DimaQSpace/TIA-for-photodiode/Altium Project/TIA_For_Photodiode.step

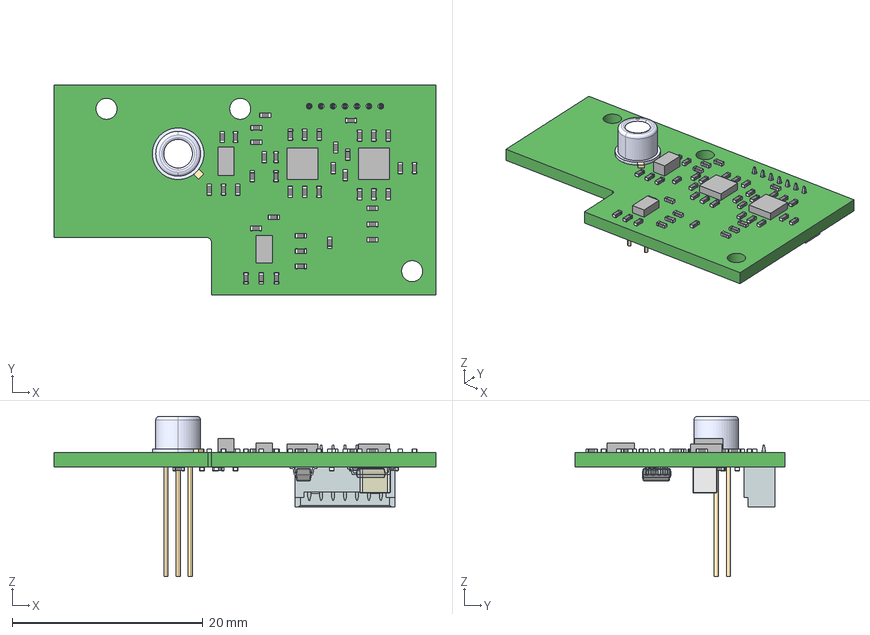
[picture p1: CAD file, 2025-07-08]
Altium Project/TIA_For_Photodiode.step
40.0 x 22.0 x 16.8 mm
res_0402 x 51
IC_BODY
IC_LEG x 5
circle
IC_LEG_MIR7 x 5
Texas Instruments
Analog Devices Logo
Extruded x 4
Cap_Murata_GRM32ER60J107ME20L_eec x 3
Picoblade 7 pins
TO-18
