DimaQSpace/TIA-for-photodiode/(list of files, drawings)

Other design files:
Altium Project/TIA_For_Photodiode.PcbDoc
Altium Project/TIA_For_Photodiode.PrjPcb
Altium Project/TIA_For_Photodiode.SchDoc
