DimaQSpace/TIA-for-photodiode/(commit log)

2025-06-19 First version TIA for photodiode PCB
    [TIA_For_Photodiode.GBL, TIA_For_Photodiode.GBO, TIA_For_Photodiode.GBP, TIA_For_Photodiode.GBS, TIA_For_Photodiode.GTL, TIA_For_Photodiode.GTO, TIA_For_Photodiode.GTP, TIA_For_Photodiode.GTS]
2025-06-28 - AD8065 footprint changed - AD8045 footprint changed - Added several bypass and filter capacitors - Added AD5245 potentiometer
    [TIA_For_Photodiode.GBL, TIA_For_Photodiode.GBO, TIA_For_Photodiode.GBP, TIA_For_Photodiode.GBS, TIA_For_Photodiode.GTL, TIA_For_Photodiode.GTO, TIA_For_Photodiode.GTP, TIA_For_Photodiode.GTS]
2025-06-28 Added 3D STEP model
    [TIA_For_Photodiode.step]
2025-07-08 1. Added power transition vias 2. Fixed the scheme
    [TIA_For_Photodiode.GBL, TIA_For_Photodiode.GBO, TIA_For_Photodiode.GBP, TIA_For_Photodiode.GBS, TIA_For_Photodiode.GTL, TIA_For_Photodiode.GTO, TIA_For_Photodiode.GTP, TIA_For_Photodiode.GTS]
2025-08-01 The nominal values of the components installed on the flight version of the board are indicated The improvements made on the flight board are indicated
    [TIA_For_Photodiode.PcbDoc, TIA_For_Photodiode.SchDoc]
2025-08-01 Added description about flight version of the photodiode board and the measurement results
    [TIA_For_Photodiode.GBL, TIA_For_Photodiode.GBO, TIA_For_Photodiode.GBP, TIA_For_Photodiode.GBS, TIA_For_Photodiode.GTL, TIA_For_Photodiode.GTO, TIA_For_Photodiode.GTP, TIA_For_Photodiode.GTS]
